Lakemountain-Keyboards/hardware/README.md

<div align="center">

  # Lakemountain Keyboards

  Hardware Repository

  Kicad Schematic & PCB layout

</div>
