Lakemountain-Keyboards/hardware/Left/Board2Pdf/left-Assembly.pdf

1 | 2 | 3 | 4 | 5 | 6

A

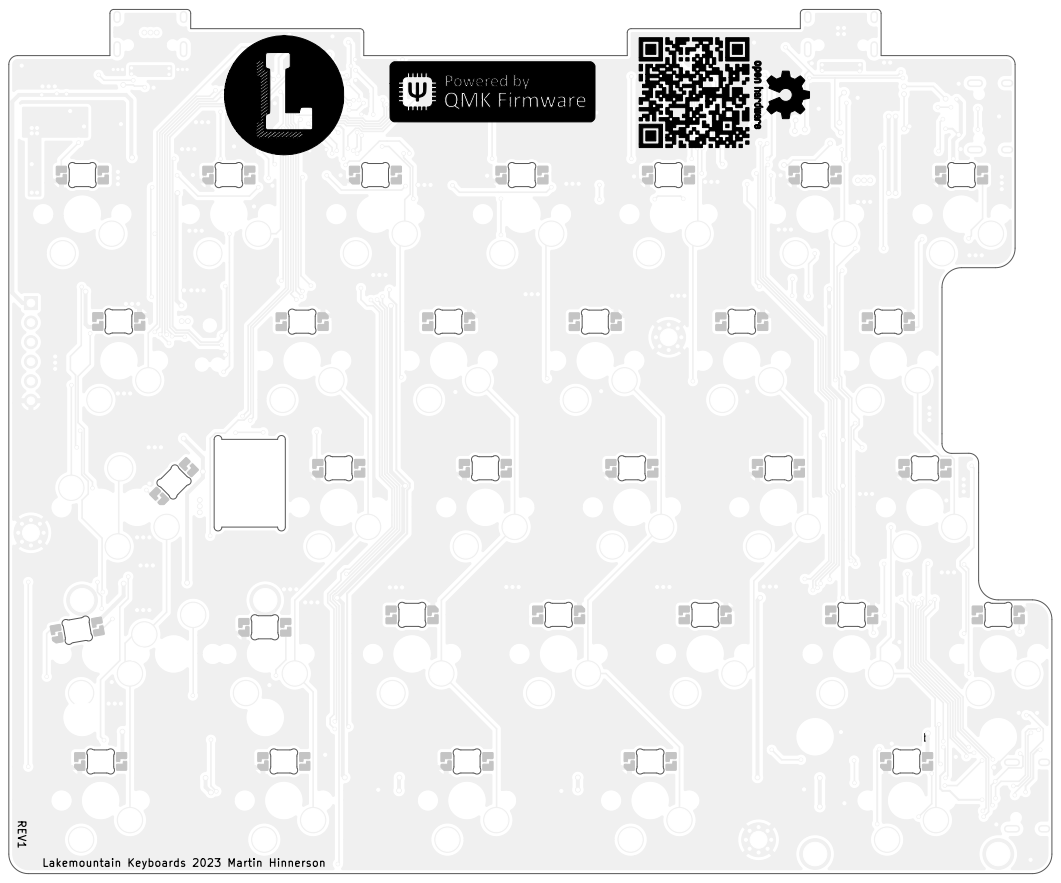
[picture p1: page 1]
D Date: 2023-03-12 KiCad; kicad; (6.0.11) Size: A4; Rev: 1; Id: 1/1 Title: Lakemountain Left File: left.kicad_pcb Sheet: BlackAndWhiteTop Lakemountain; Keyboards; MX_stab; MX_stab REV1; Lakemountain Keyboards 2023 Martin Hinnerson

1 | 2 | 3 | 4 | 5 | 6 1 | 2 | 3 | 4 | 5 | 6 ABCD | ABCD Date: 2023-03-12 KiCad | E.D.A. | kicad | (6.0.11) Size: A4 | Rev: 1
Lakemountain | Keyboards T15 | T13 ⁵.1k | R13 5.1k | R5 MUX_SEL SRV05-4 U11 SRV05-4 | U10

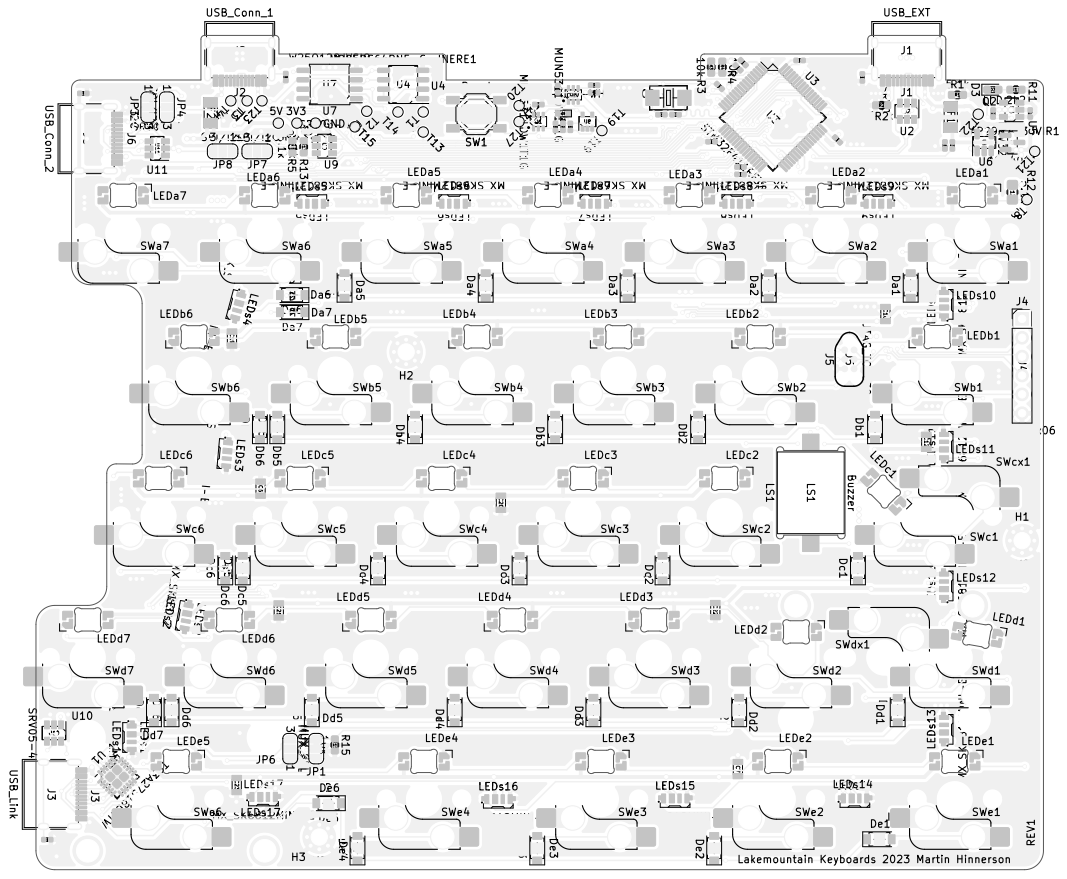
[picture p2: page 2]

Id: 1/1 Title: Lakemountain Left File: left.kicad_pcb Sheet: BlackAndWhiteBottom
