Lakemountain-Keyboards/hardware/Left/left.kicad_pcb

## KiCad design Left/left.kicad_pcb (2024-03-15)

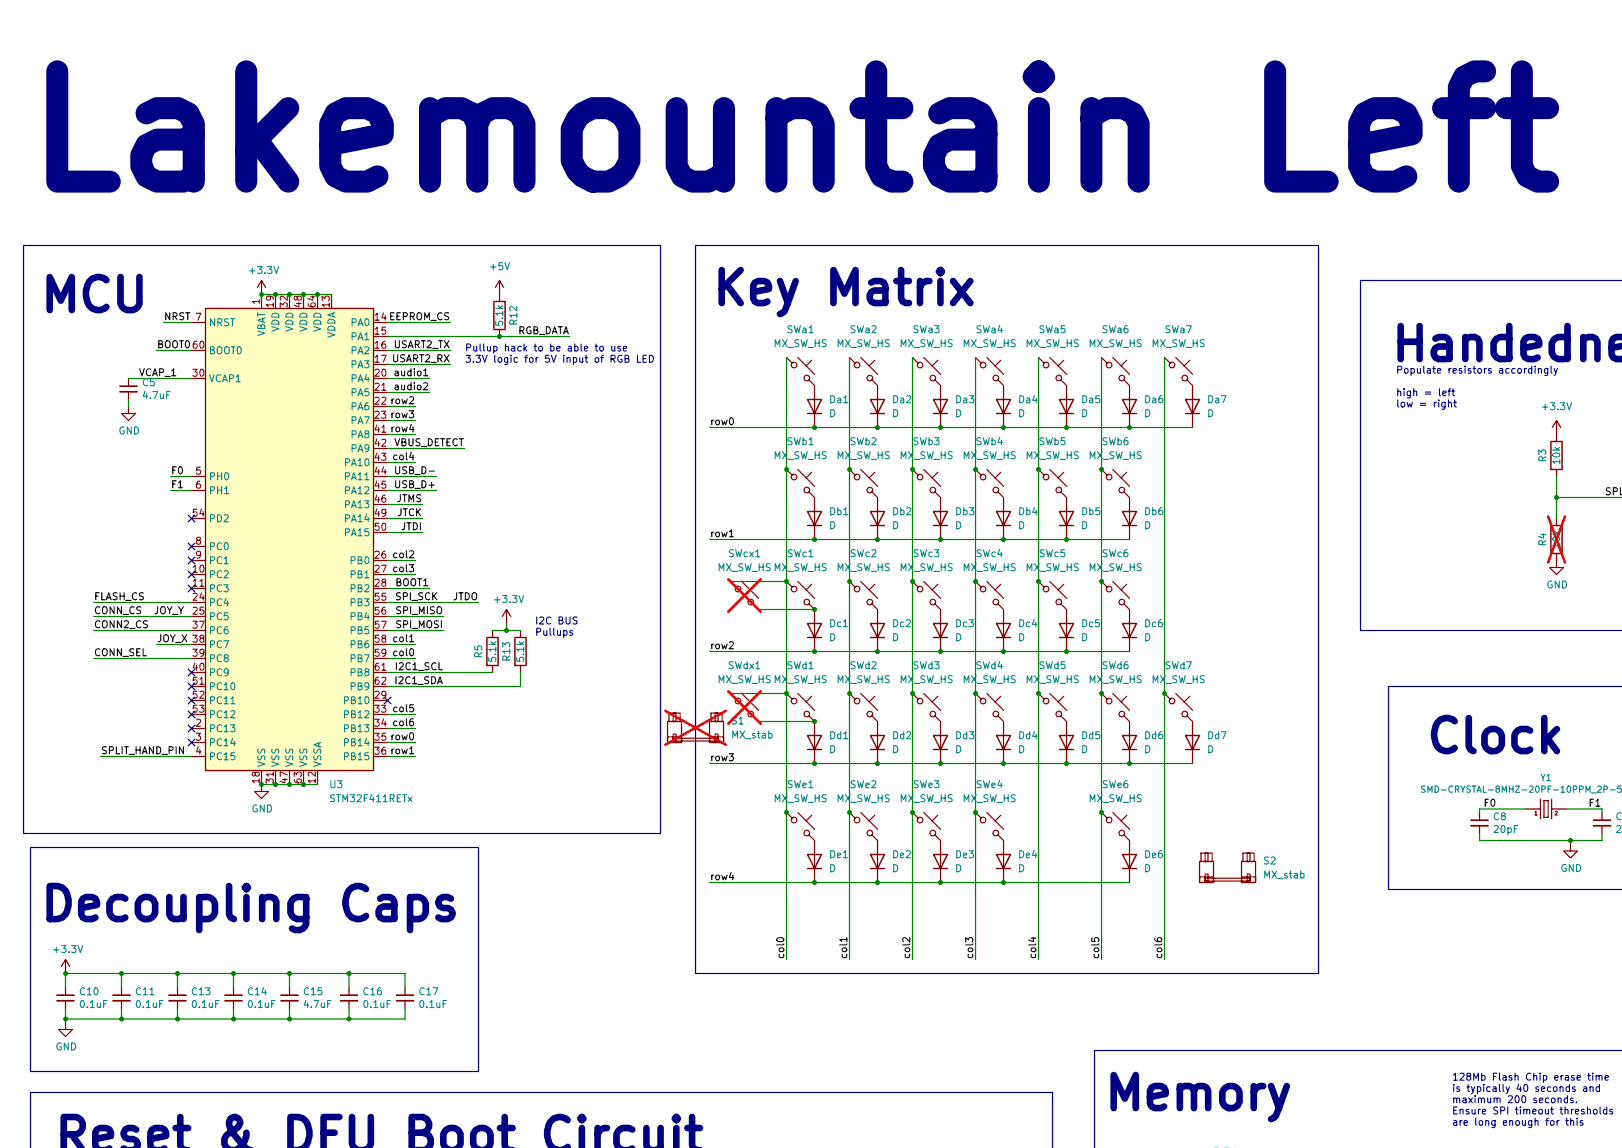
[picture p3: schematic left.kicad_sch, Lakemountain Left, part in row 1, column 1]

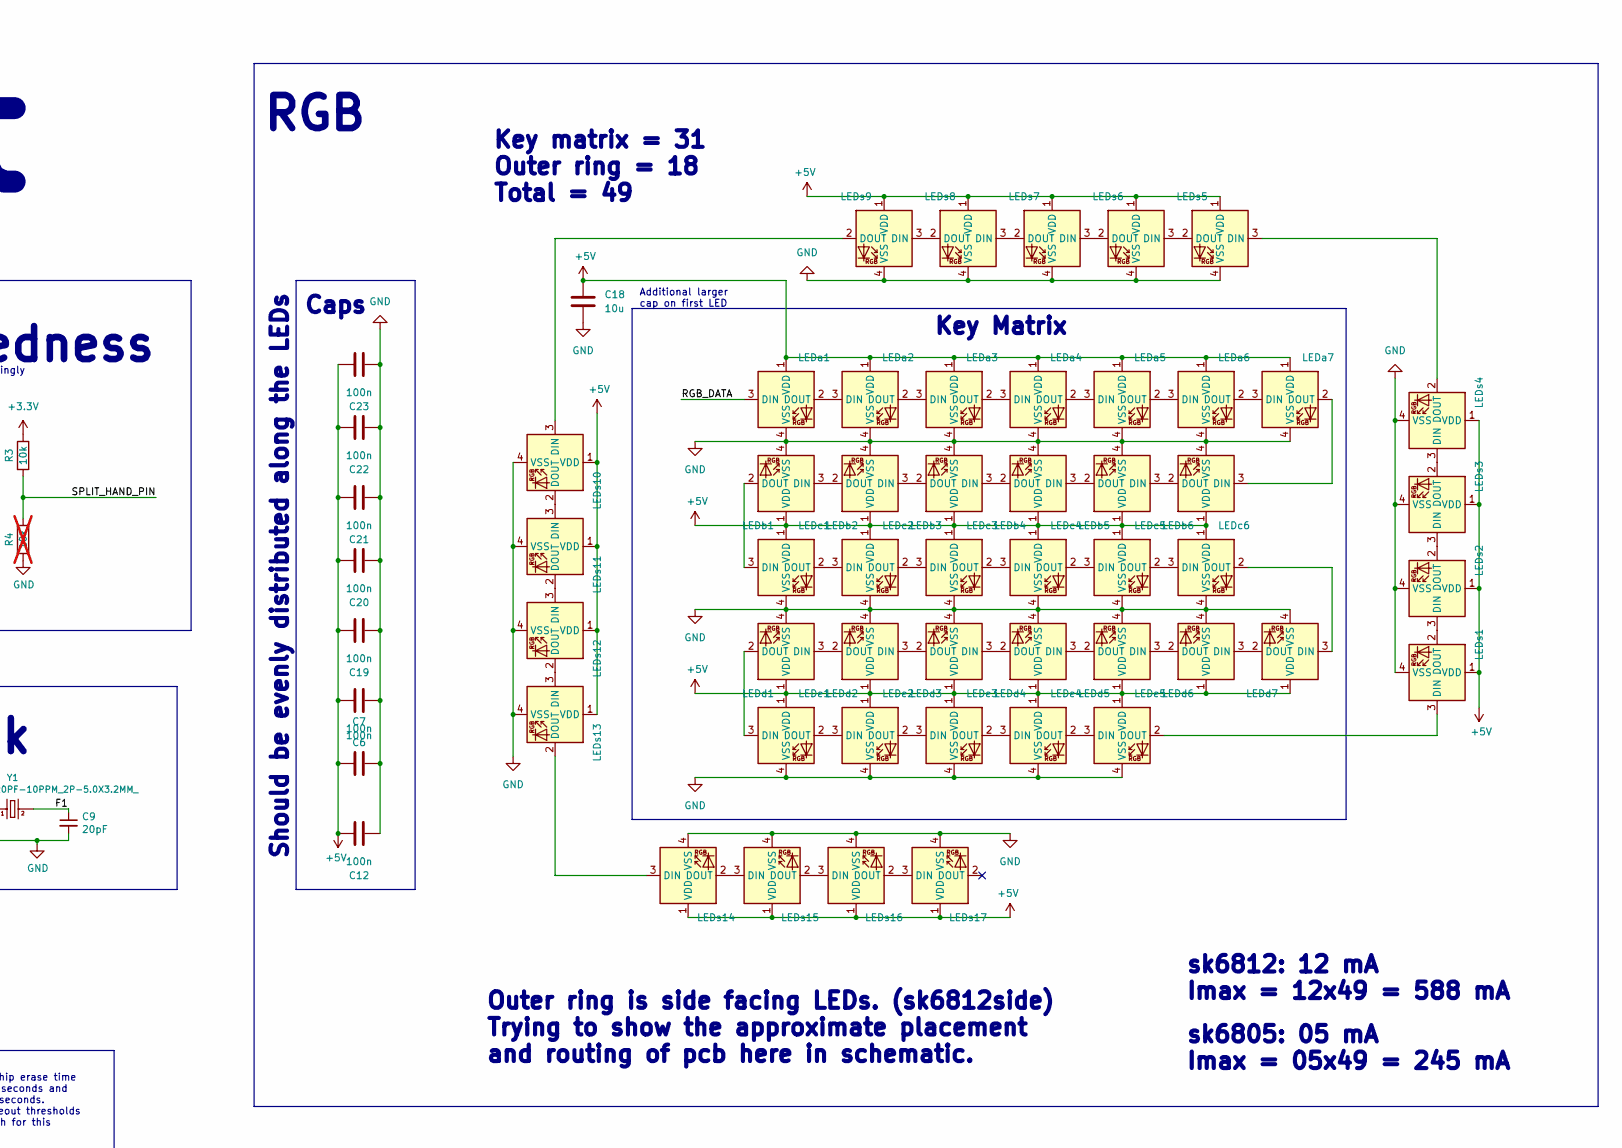
[picture p4: schematic left.kicad_sch, Lakemountain Left, part in row 1, column 2]

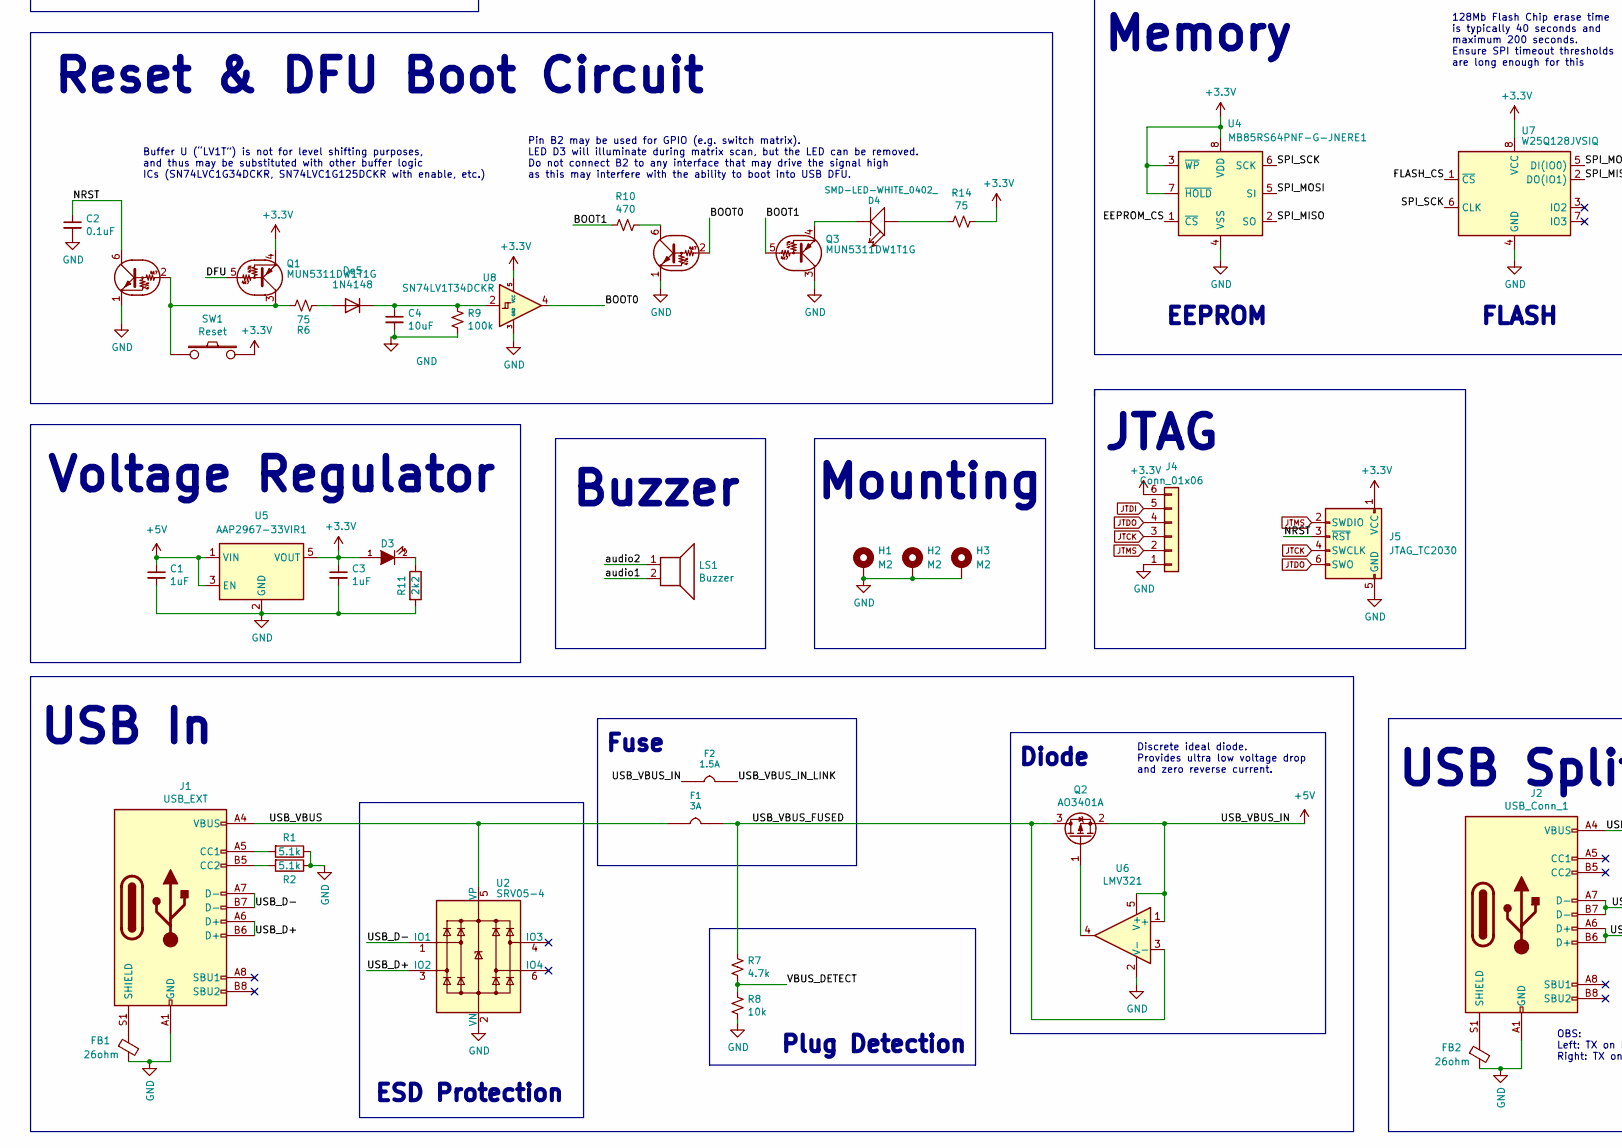
[picture p5: schematic left.kicad_sch, Lakemountain Left, part in row 2, column 1]

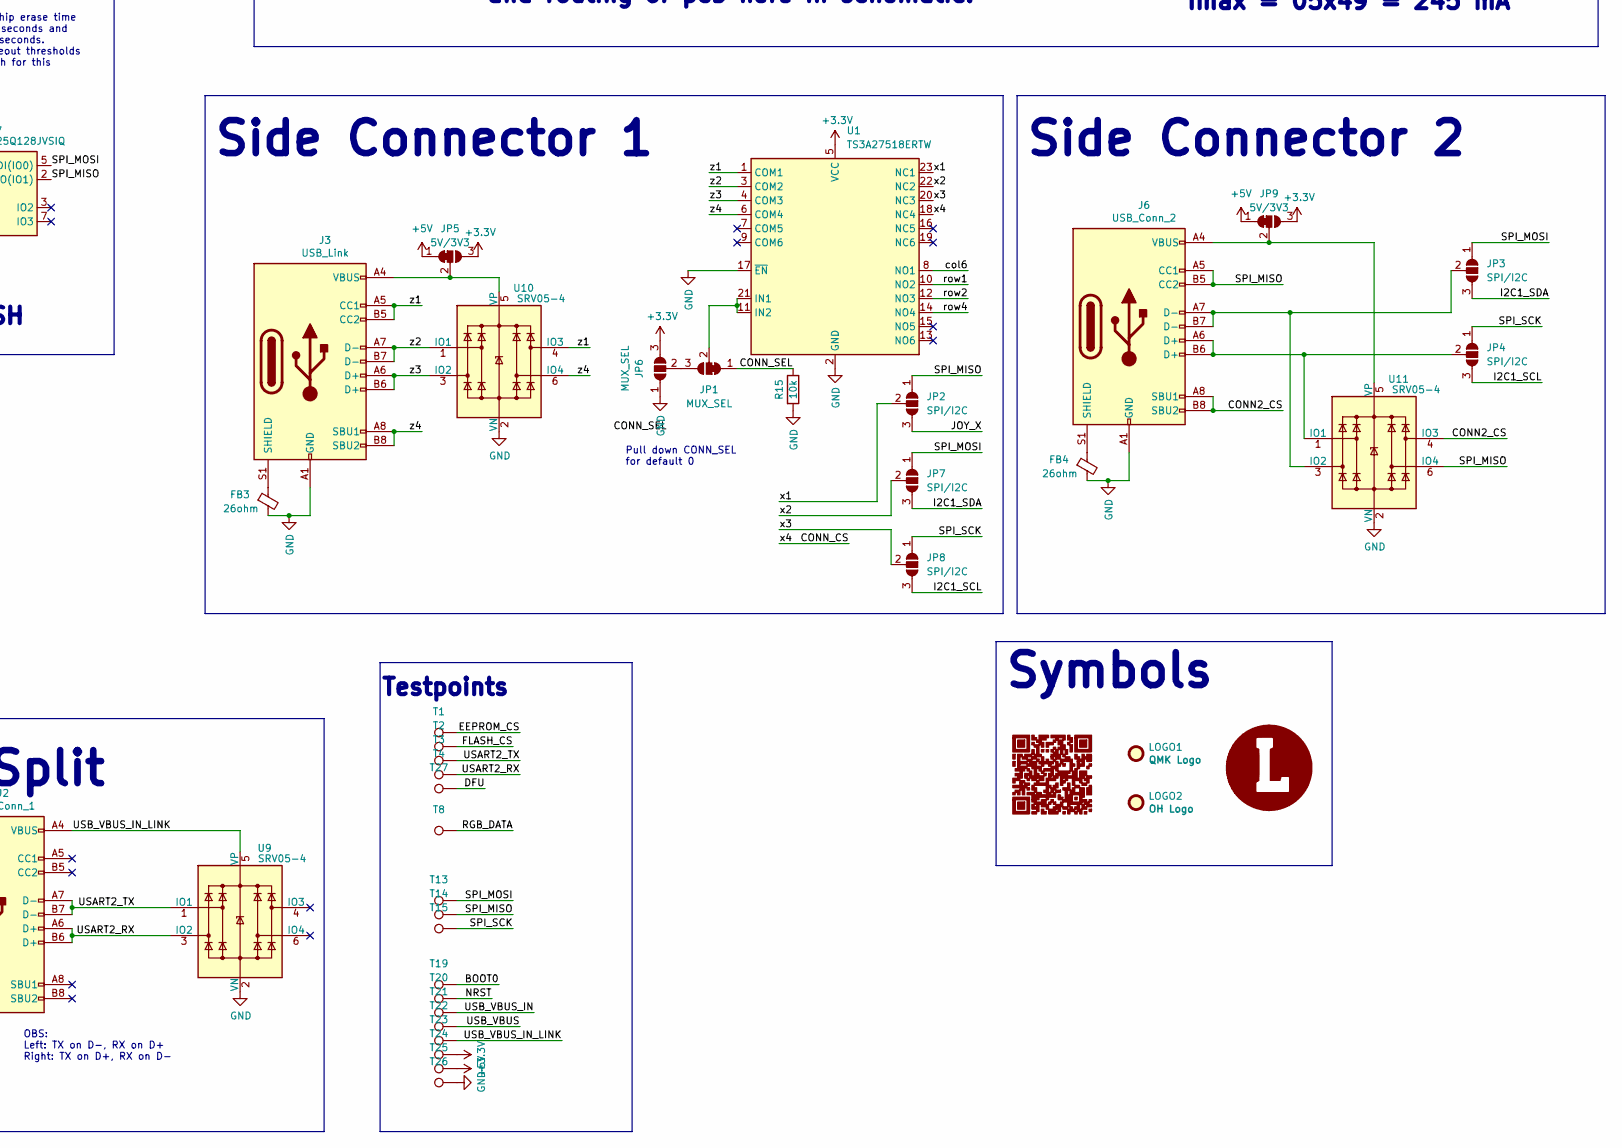
[picture p6: schematic left.kicad_sch, Lakemountain Left, part in row 2, column 2]

Parts:
C1, C3: cap_1uF_10v_0402; C_0402_1005Metric; MPN CC0402KRX5R6BB105; LCSC C52923
C2, C10, C11, C13, C14, C16, C17: cap_100nF_16v_0402; C_0402_1005Metric; MPN CL05B104KO5NNNC; LCSC C1525
C4: cap_10uF_10v_0402; C_0402_1005Metric; MPN CL10A106KP8NNNC; LCSC C19702
C5, C15: cap_4.7uF_10v_0402; C_0402_1005Metric; MPN CL05A475MP5NRNC; LCSC C23733
C6, C7, C12, C19, C20, C21, C22, C23: 100n; C_0805; LCSC C495959
C8, C9: cap_20pF_50v_0402; C_0402_1005Metric; MPN 0402CG200J500NT; LCSC C1554
C18: 10u; C_0805; LCSC C90544
D3: LED; LED_0603_1608Metric; LCSC Part C72041
D4: SMD-LED-WHITE_0402_; LED_0402; MPN 16-219A/T2D-AR2T1QY/3T; LCSC C74342
Da1, Da2, Da3, Da4, Da5, Da6, Da7: D; D_SOD-123; LCSC C81598
Db1, Db2, Db3, Db4, Db5, Db6: D; D_SOD-123; LCSC C81598
Dc1, Dc2, Dc3, Dc4, Dc5, Dc6: D; D_SOD-123; LCSC C81598
Dd1, Dd2, Dd3, Dd4, Dd5, Dd6, Dd7: D; D_SOD-123; LCSC C81598
De1, De2, De3, De4, De6: D; D_SOD-123; LCSC C81598
De5: 1N4148; D_SOD-523; LCSC C68948
F1: 3A; F1206; MPN SMD0805-050; LCSC C89656
F2: 1.5A; F1206; MPN SMD0805-050; LCSC C89655
FB1, FB2, FB3, FB4: fb_0402_26ohm; R_0402_1005Metric; MPN CBG100505U260T; LCSC C668229
H1, H2, H3: M2; MountingHole_2.2mm_M2_Pad_Via
J1: USB_EXT; USB_C_Receptacle_HRO_TYPE-C-31-M-12; Mouser C165948
J2: USB_Conn_1; USB_C_Receptacle_HRO_TYPE-C-31-M-12; Mouser C165948
J3: USB_Link; USB_C_Receptacle_HRO_TYPE-C-31-M-12; Mouser C165948
J4: Conn_01x06; PinHeader_1x06_P2.54mm_Vertical
J5: JTAG_TC2030; CON_TC2030_outlined
J6: USB_Conn_2; USB_C_Receptacle_HRO_TYPE-C-31-M-12; Mouser C165948
JP1: MUX_SEL; SolderJumper-3_P1.3mm_Bridged12_RoundedPad1.0x1.5mm
JP2, JP3, JP4, JP7, JP8: SPI/I2C; SolderJumper-3_P1.3mm_Open_RoundedPad1.0x1.5mm_NumberLabels
JP5, JP9: 5V/3V3; SolderJumper-3_P1.3mm_Bridged12_RoundedPad1.0x1.5mm
JP6: MUX_SEL; SolderJumper-3_P1.3mm_Open_RoundedPad1.0x1.5mm_NumberLabels
LEDa1, LEDa2, LEDa3, LEDa4, LEDa5, LEDa6, LEDa7: MX_SK6812MINI-E; LED_MX_6028R; LCSC C5149201
LEDb1, LEDb2, LEDb3, LEDb4, LEDb5, LEDb6: MX_SK6812MINI-E; LED_MX_6028R_Flipped; LCSC C5149201
LEDc1: MX_SK6812MINI-E; LED_MX_6028R_SOLO; LCSC C5149201
LEDc2, LEDc3, LEDc4, LEDc5, LEDc6: MX_SK6812MINI-E; LED_MX_6028R; LCSC C5149201
LEDd1, LEDd2: MX_SK6812MINI-E; LED_MX_6028R_SOLO; LCSC C5149201
LEDd3, LEDd4, LEDd5, LEDd6, LEDd7: MX_SK6812MINI-E; LED_MX_6028R_Flipped; LCSC C5149201
LEDe1, LEDe2, LEDe3, LEDe4, LEDe5: MX_SK6812MINI-E; LED_MX_6028R; LCSC C5149201
LEDs1, LEDs2, LEDs3, LEDs4, LEDs5, LEDs6, LEDs7, LEDs8, LEDs9, LEDs10, LEDs11, LEDs12, LEDs13, LEDs14, LEDs15, LEDs16, LEDs17: sk6812side; LCSC C2890037
LOGO1: QMK Logo; QMK_PoweredBy
LOGO2: OH Logo; OSHW-Logo2_9.8x8mm_SilkScreen
LS1: Buzzer; Buzzer_Mallory_AST1109MLTRQ; LCSC C201047
Q1, Q3: MUN5311DW1T1G; SOT-363_SC-70-6_SC-88; LCSC C152542
Q2: AO3401A; SOT-23; LCSC Part C15127
R1, R2, R5, R13: 5.1k; R_0603_1608Metric; Mouser C27834
R3, R15: 10k; R_0603_1608Metric; LCSC C25804
R4: 10k; R_0603_1608Metric; LCSC C25804; not fitted
R6, R14: r_75_0402_1p; R_0402_1005Metric; MPN 0402WGF750JTCE; LCSC C25133
R7: r_4.7k_0402_1p; R_0402_1005Metric; MPN 0402WGF4701TCE; LCSC C25900
R8: r_10k_0402_1p; R_0402_1005Metric; MPN 0402WGF1002TCE; LCSC C25744
R9: r_100k_0402_1p; R_0402_1005Metric; MPN 0402WGF1003TCE; LCSC C25741
R10: r_470_0402_1p; R_0402_1005Metric; MPN 0402WGF4700TCE; LCSC C25117
R11: 2k2; R_0603_1608Metric; LCSC C4190
R12: 5.1k; R_0805_2012Metric_Pad1.20x1.40mm_HandSolder; Mouser C27834
S1: MX_stab; STAB_MX_P_2.25u; JLCPCB BOM 0; not fitted
S2: MX_stab; STAB_MX_P_2.25u; JLCPCB BOM 0
SW1: Reset; SW_SPST_TL3342; Mouser C318884
SWa1, SWa2, SWa3, SWa4, SWa5, SWa6, SWa7: MX_SW_HS; SW_MX_HS_1u; LCSC C2803348
SWb1: MX_SW_HS; SW_MX_HS_1.5u; LCSC C2803348
SWb2, SWb3, SWb4, SWb5, SWb6: MX_SW_HS; SW_MX_HS_1u; LCSC C2803348
SWc1: MX_SW_HS; SW_MX_HS_1.75u; LCSC C2803348
SWc2, SWc3, SWc4, SWc5, SWc6: MX_SW_HS; SW_MX_HS_1u; LCSC C2803348
SWcx1: MX_SW_HS; SW_MX_HS_1.75u_stp; LCSC C2803348; not fitted
SWd1: MX_SW_HS; SW_MX_HS_1.25u; LCSC C2803348
SWd2, SWd3, SWd4, SWd5, SWd6, SWd7: MX_SW_HS; SW_MX_HS_1u; LCSC C2803348
SWdx1: MX_SW_HS; SW_MX_HS_2.25u; LCSC C2803348; not fitted
SWe1, SWe2, SWe3, SWe4: MX_SW_HS; SW_MX_HS_1.25u; LCSC C2803348
SWe6: MX_SW_HS; SW_MX_HS_2.25u; LCSC C2803348
T1, T2, T3, T4, T8, T13, T14, T15, T19, T20, T21, T22, T23: TP; TestPoint_Pad_D1.0mm
T24: 3V3; TestPoint_Pad_D1.0mm
T25: 5V; TestPoint_Pad_D1.0mm
T26, T27: GND; TestPoint_Pad_D1.0mm
U1: TS3A27518ERTW; WQFN-24-1EP_4x4mm_P0.5mm_EP2.6x2.6mm; LCSC C2651937
U2, U9, U10, U11: SRV05-4; SOT-23-6; LCSC C85364
U3: STM32F411RETx; LQFP-64_10x10mm_P0.5mm
U4: MB85RS64PNF-G-JNERE1; SOP-8_3.9x4.9mm_P1.27mm; LCSC C8741
U5: AAP2967-33VIR1; SOT-23-5; LCSC C370742
U6: LMV321; SOT-23-5; JLCPCB BOM 1
U7: W25Q128JVSIQ; SOIC-8_5.23x5.23mm_P1.27mm; LCSC C97521
U8: SN74LV1T34DCKR; SOT-353_SC-70-5; LCSC C78541
Y1: SMD-CRYSTAL-8MHZ-20PF-10PPM_2P-5.0X3.2MM_; X2-SMD-5.0X3.2X1.3MM; MPN X50328MSB2GI; LCSC C115962

Connections:
+3.3V: C3.1, C10.1, C11.1, C13.1, C14.1, C15.1, C16.1, C17.1, D3.1 (A), J4.6, J5.1 (VCC), JP5.3 (B), JP6.3 (B), JP9.3 (B), Q1.4 (E), R3.1, R5.1, R13.1, R14.1, SW1.2, T24.1, U1.5 (VCC), U3.1 (VBAT), U3.13 (VDDA), U3.19 (VDD), U3.32 (VDD), U3.48 (VDD), U3.64 (VDD), U4.3 (~WP), U4.7 (~HOLD), U4.8 (VDD), U5.5 (VOUT), U7.8 (VCC), U8.5 (VCC)
+5V: C1.1, C6.1, C7.1, C12.1, C18.1, C19.1, C20.2, C21.1, C22.2, C23.1, F2.2, JP5.1 (A), JP9.1 (A), LEDa1.1 (VDD), LEDa2.1 (VDD), LEDa3.1 (VDD), LEDa4.1 (VDD), LEDa5.1 (VDD), LEDa6.1 (VDD), LEDa7.1 (VDD), LEDb1.1 (VDD), LEDb2.1 (VDD), LEDb3.1 (VDD), LEDb4.1 (VDD), LEDb5.1 (VDD), LEDb6.1 (VDD), LEDc1.1 (VDD), LEDc2.1 (VDD), LEDc3.1 (VDD), LEDc4.1 (VDD), LEDc5.1 (VDD), LEDc6.1 (VDD), LEDd1.1 (VDD), LEDd2.1 (VDD), LEDd3.1 (VDD), LEDd4.1 (VDD), LEDd5.1 (VDD), LEDd6.1 (VDD), LEDd7.1 (VDD), LEDe1.1 (VDD), LEDe2.1 (VDD), LEDe3.1 (VDD), LEDe4.1 (VDD), LEDe5.1 (VDD), LEDs1.1 (VDD), LEDs2.1 (VDD), LEDs3.1 (VDD), LEDs4.1 (VDD), LEDs5.1 (VDD), LEDs6.1 (VDD), LEDs7.1 (VDD), LEDs8.1 (VDD), LEDs9.1 (VDD), LEDs10.1 (VDD), LEDs11.1 (VDD), LEDs12.1 (VDD), LEDs13.1 (VDD), LEDs14.1 (VDD), LEDs15.1 (VDD), LEDs16.1 (VDD), LEDs17.1 (VDD), Q2.2 (S), R12.2, T21.1, T25.1, U5.1 (VIN), U5.3 (EN), U6.1 (+), U6.5 (V+)
/BOOT0: Q3.2 (B), T19.1, U3.60 (BOOT0), U8.4
/BOOT1: Q3.5, R10.2, U3.28 (PB2)
/CONN2_CS: J6.A8 (SBU1), J6.B8 (SBU2), U3.37 (PC6), U11.4 (IO3)
/CONN_CS: U1.18 (NC4), U3.25 (PC5)
/CONN_SEL: JP1.1 (A), R15.1, U3.39 (PC8)
/DFU: Q1.5, T27.1
/EEPROM_CS: T1.1, U3.14 (PA0), U4.1 (~CS)
/F0: C8.1, U3.5 (PH0), Y1.1
/F1: C9.1, U3.6 (PH1), Y1.2
/FLASH_CS: T2.1, U3.24 (PC4), U7.1 (~CS)
/I2C1_SCL: JP4.3 (B), JP8.3 (B), R5.2, U3.61 (PB8)
/I2C1_SDA: JP3.3 (B), JP7.3 (B), R13.2, U3.62 (PB9)
/JOY_X: JP2.3 (B), U3.38 (PC7)
/NRST: C2.1, J5.3 (~RST), Q1.6 (C), T20.1, U3.7 (NRST)
/RGB_DATA: LEDa1.3 (DIN), R12.1, T8.1, U3.15 (PA1)
/SPI_MISO: J6.A5 (CC1), J6.B5 (CC2), JP2.1 (A), T14.1, U3.56 (PB4), U4.2 (SO), U7.2 (DO(IO1)), U11.6 (IO4)
/SPI_MOSI: JP3.1 (A), JP7.1 (A), T13.1, U3.57 (PB5), U4.5 (SI), U7.5 (DI(IO0))
/SPLIT_HAND_PIN: R3.2, R4.1, U3.4 (PC15)
/USART2_RX: J2.A6 (D+), J2.B6 (D+), T4.1, U3.17 (PA3), U9.3 (IO2)
/USART2_TX: J2.A7 (D-), J2.B7 (D-), T3.1, U3.16 (PA2), U9.1 (IO1)
/USB_D+: J1.A6 (D+), J1.B6 (D+), U2.3 (IO2), U3.45 (PA12)
/USB_D-: J1.A7 (D-), J1.B7 (D-), U2.1 (IO1), U3.44 (PA11)
/USB_VBUS: F1.2, J1.A4 (VBUS), J1.A9 (VBUS), J1.B4 (VBUS), J1.B9 (VBUS), T22.1, U2.5 (VP)
/USB_VBUS_FUSED: F1.1, Q2.3 (D), R7.1, U6.3 (-)
/USB_VBUS_IN_LINK: F2.1, J2.A4 (VBUS), J2.A9 (VBUS), J2.B4 (VBUS), J2.B9 (VBUS), T23.1, U9.5 (VP)
/VBUS_DETECT: R7.2, R8.1, U3.42 (PA9)
/VCAP_1: C5.1, U3.30 (VCAP1)
/audio1: LS1.2, U3.20 (PA4)
/audio2: LS1.1, U3.21 (PA5)
/col0: SWa1.1, SWb1.1, SWc1.1, SWcx1.1, SWd1.1, SWdx1.1, SWe1.1, U3.59 (PB7)
/col1: SWa2.1, SWb2.1, SWc2.1, SWd2.1, SWe2.1, U3.58 (PB6)
/col2: SWa3.1, SWb3.1, SWc3.1, SWd3.1, SWe3.1, U3.26 (PB0)
/col3: SWa4.1, SWb4.1, SWc4.1, SWd4.1, SWe4.1, U3.27 (PB1)
/col4: SWa5.1, SWb5.1, SWc5.1, SWd5.1, U3.43 (PA10)
/col5: SWa6.1, SWb6.1, SWc6.1, SWd6.1, SWe6.1, U3.33 (PB12)
/col6: SWa7.1, SWd7.1, U1.8 (NO1), U3.34 (PB13)
/row0: Da1.1 (K), Da2.1 (K), Da3.1 (K), Da4.1 (K), Da5.1 (K), Da6.1 (K), Da7.1 (K), U3.35 (PB14)
/row1: Db1.1 (K), Db2.1 (K), Db3.1 (K), Db4.1 (K), Db5.1 (K), Db6.1 (K), U1.10 (NO2), U3.36 (PB15)
/row2: Dc1.1 (K), Dc2.1 (K), Dc3.1 (K), Dc4.1 (K), Dc5.1 (K), Dc6.1 (K), U1.12 (NO3), U3.22 (PA6)
/row3: Dd1.1 (K), Dd2.1 (K), Dd3.1 (K), Dd4.1 (K), Dd5.1 (K), Dd6.1 (K), Dd7.1 (K), U3.23 (PA7)
/row4: De1.1 (K), De2.1 (K), De3.1 (K), De4.1 (K), De6.1 (K), U1.14 (NO4), U3.41 (PA8)
/x1: JP2.2 (C), U1.23 (NC1)
/x2: JP7.2 (C), U1.22 (NC2)
/x3: JP8.2 (C), U1.20 (NC3)
/z1: J3.A5 (CC1), J3.B5 (CC2), U1.1 (COM1), U10.4 (IO3)
/z2: J3.A7 (D-), J3.B7 (D-), U1.3 (COM2), U10.1 (IO1)
/z3: J3.A6 (D+), J3.B6 (D+), U1.4 (COM3), U10.3 (IO2)
/z4: J3.A8 (SBU1), J3.B8 (SBU2), U1.6 (COM4), U10.6 (IO4)
GND: C1.2, C2.2, C3.2, C4.2, C5.2, C6.2, C7.2, C8.2, C9.2, C10.2, C11.2, C12.2, C13.2, C14.2, C15.2, C16.2, C17.2, C18.2, C19.2, C20.1, C21.2, C22.1, C23.2, FB1.2, FB2.2, FB3.2, FB4.2, H1.1, H2.1, H3.1, J1.A1 (GND), J1.A12 (GND), J1.B1 (GND), J1.B12 (GND), J2.A1 (GND), J2.A12 (GND), J2.B1 (GND), J2.B12 (GND), J3.A1 (GND), J3.A12 (GND), J3.B1 (GND), J3.B12 (GND), J4.1, J5.5 (GND), J6.A1 (GND), J6.A12 (GND), J6.B1 (GND), J6.B12 (GND), JP6.1 (A), LEDa1.4 (VSS), LEDa2.4 (VSS), LEDa3.4 (VSS), LEDa4.4 (VSS), LEDa5.4 (VSS), LEDa6.4 (VSS), LEDa7.4 (VSS), LEDb1.4 (VSS), LEDb2.4 (VSS), LEDb3.4 (VSS), LEDb4.4 (VSS), LEDb5.4 (VSS), LEDb6.4 (VSS), LEDc1.4 (VSS), LEDc2.4 (VSS), LEDc3.4 (VSS), LEDc4.4 (VSS), LEDc5.4 (VSS), LEDc6.4 (VSS), LEDd1.4 (VSS), LEDd2.4 (VSS), LEDd3.4 (VSS), LEDd4.4 (VSS), LEDd5.4 (VSS), LEDd6.4 (VSS), LEDd7.4 (VSS), LEDe1.4 (VSS), LEDe2.4 (VSS), LEDe3.4 (VSS), LEDe4.4 (VSS), LEDe5.4 (VSS), LEDs1.4 (VSS), LEDs2.4 (VSS), LEDs3.4 (VSS), LEDs4.4 (VSS), LEDs5.4 (VSS), LEDs6.4 (VSS), LEDs7.4 (VSS), LEDs8.4 (VSS), LEDs9.4 (VSS), LEDs10.4 (VSS), LEDs11.4 (VSS), LEDs12.4 (VSS), LEDs13.4 (VSS), LEDs14.4 (VSS), LEDs15.4 (VSS), LEDs16.4 (VSS), LEDs17.4 (VSS), Q1.1 (E), Q3.1 (E), Q3.3 (C), R1.1, R2.1, R4.2, R8.2, R9.2, R11.2, R15.2, T26.1, U1.2 (GND), U1.17 (~EN), U1.25 (GND), U2.2 (VN), U3.12 (VSSA), U3.18 (VSS), U3.31 (VSS), U3.47 (VSS), U3.63 (VSS), U4.4 (VSS), U5.2 (GND), U6.2 (V-), U7.4 (GND), U8.3 (GND), U9.2 (VN), U10.2 (VN), U11.2 (VN)
JTCK: J4.3, J5.4 (SWCLK), U3.49 (PA14)
JTDI: J4.5, U3.50 (PA15)
JTDO: J4.4, J5.6 (SWO), JP4.1 (A), JP8.1 (A), T15.1, U3.55 (PB3), U4.6 (SCK), U7.6 (CLK)
JTMS: J4.2, J5.2 (SWDIO), U3.46 (PA13)
unnamed: D3.2 (K), R11.1
unnamed: D4.+, R14.2
unnamed: D4.-, Q3.4 (E)
unnamed: Da1.2 (A), SWa1.2
unnamed: Da2.2 (A), SWa2.2
unnamed: Da3.2 (A), SWa3.2
unnamed: Da4.2 (A), SWa4.2
unnamed: Da5.2 (A), SWa5.2
unnamed: Da6.2 (A), SWa6.2
unnamed: Da7.2 (A), SWa7.2
unnamed: Db1.2 (A), SWb1.2
unnamed: Db2.2 (A), SWb2.2
unnamed: Db3.2 (A), SWb3.2
unnamed: Db4.2 (A), SWb4.2
unnamed: Db5.2 (A), SWb5.2
unnamed: Db6.2 (A), SWb6.2
unnamed: Dc1.2 (A), SWc1.2, SWcx1.2
unnamed: Dc2.2 (A), SWc2.2
unnamed: Dc3.2 (A), SWc3.2
unnamed: Dc4.2 (A), SWc4.2
unnamed: Dc5.2 (A), SWc5.2
unnamed: Dc6.2 (A), SWc6.2
unnamed: Dd1.2 (A), SWd1.2, SWdx1.2
unnamed: Dd2.2 (A), SWd2.2
unnamed: Dd3.2 (A), SWd3.2
unnamed: Dd4.2 (A), SWd4.2
unnamed: Dd5.2 (A), SWd5.2
unnamed: Dd6.2 (A), SWd6.2
unnamed: Dd7.2 (A), SWd7.2
unnamed: De1.2 (A), SWe1.2
unnamed: De2.2 (A), SWe2.2
unnamed: De3.2 (A), SWe3.2
unnamed: De4.2 (A), SWe4.2
unnamed: De5.2 (A), R6.2
unnamed: C4.1, De5.1 (K), R9.1, U8.2
unnamed: De6.2 (A), SWe6.2
unnamed: J1.A5 (CC1), R1.2
unnamed: J1.B5 (CC2), R2.2
unnamed: FB1.1, J1.S1 (SHIELD)
unnamed: FB2.1, J2.S1 (SHIELD)
unnamed: FB3.1, J3.S1 (SHIELD)
unnamed: FB4.1, J6.S1 (SHIELD)
unnamed: JP1.3 (B), JP6.2 (C)
unnamed: JP1.2 (C), U1.11 (IN2), U1.21 (IN1)
unnamed: J6.A7 (D-), J6.B7 (D-), JP3.2 (C), U11.3 (IO2)
unnamed: J6.A6 (D+), J6.B6 (D+), JP4.2 (C), U11.1 (IO1)
unnamed: J3.A4 (VBUS), J3.A9 (VBUS), J3.B4 (VBUS), J3.B9 (VBUS), JP5.2 (C), U10.5 (VP)
unnamed: J6.A4 (VBUS), J6.A9 (VBUS), J6.B4 (VBUS), J6.B9 (VBUS), JP9.2 (C), U11.5 (VP)
unnamed: LEDa1.2 (DOUT), LEDa2.3 (DIN)
unnamed: LEDa2.2 (DOUT), LEDa3.3 (DIN)
unnamed: LEDa3.2 (DOUT), LEDa4.3 (DIN)
unnamed: LEDa4.2 (DOUT), LEDa5.3 (DIN)
unnamed: LEDa5.2 (DOUT), LEDa6.3 (DIN)
unnamed: LEDa6.2 (DOUT), LEDa7.3 (DIN)
unnamed: LEDa7.2 (DOUT), LEDb6.3 (DIN)
unnamed: LEDb1.3 (DIN), LEDb2.2 (DOUT)
unnamed: LEDb1.2 (DOUT), LEDc1.3 (DIN)
unnamed: LEDb2.3 (DIN), LEDb3.2 (DOUT)
unnamed: LEDb3.3 (DIN), LEDb4.2 (DOUT)
unnamed: LEDb4.3 (DIN), LEDb5.2 (DOUT)
unnamed: LEDb5.3 (DIN), LEDb6.2 (DOUT)
unnamed: LEDc1.2 (DOUT), LEDc2.3 (DIN)
unnamed: LEDc2.2 (DOUT), LEDc3.3 (DIN)
unnamed: LEDc3.2 (DOUT), LEDc4.3 (DIN)
unnamed: LEDc4.2 (DOUT), LEDc5.3 (DIN)
unnamed: LEDc5.2 (DOUT), LEDc6.3 (DIN)
unnamed: LEDc6.2 (DOUT), LEDd7.3 (DIN)
unnamed: LEDd1.3 (DIN), LEDd2.2 (DOUT)
unnamed: LEDd1.2 (DOUT), LEDe1.3 (DIN)
unnamed: LEDd2.3 (DIN), LEDd3.2 (DOUT)
unnamed: LEDd3.3 (DIN), LEDd4.2 (DOUT)
unnamed: LEDd4.3 (DIN), LEDd5.2 (DOUT)
unnamed: LEDd5.3 (DIN), LEDd6.2 (DOUT)
unnamed: LEDd6.3 (DIN), LEDd7.2 (DOUT)
unnamed: LEDe1.2 (DOUT), LEDe2.3 (DIN)
unnamed: LEDe2.2 (DOUT), LEDe3.3 (DIN)
unnamed: LEDe3.2 (DOUT), LEDe4.3 (DIN)
unnamed: LEDe4.2 (DOUT), LEDe5.3 (DIN)
unnamed: LEDe5.2 (DOUT), LEDs1.3 (DIN)
unnamed: LEDs1.2 (DOUT), LEDs2.3 (DIN)
unnamed: LEDs2.2 (DOUT), LEDs3.3 (DIN)
unnamed: LEDs3.2 (DOUT), LEDs4.3 (DIN)
unnamed: LEDs4.2 (DOUT), LEDs5.3 (DIN)
unnamed: LEDs5.2 (DOUT), LEDs6.3 (DIN)
unnamed: LEDs6.2 (DOUT), LEDs7.3 (DIN)
unnamed: LEDs7.2 (DOUT), LEDs8.3 (DIN)
unnamed: LEDs8.2 (DOUT), LEDs9.3 (DIN)
unnamed: LEDs9.2 (DOUT), LEDs10.3 (DIN)
unnamed: LEDs10.2 (DOUT), LEDs11.3 (DIN)
unnamed: LEDs11.2 (DOUT), LEDs12.3 (DIN)
unnamed: LEDs12.2 (DOUT), LEDs13.3 (DIN)
unnamed: LEDs13.2 (DOUT), LEDs14.3 (DIN)
unnamed: LEDs14.2 (DOUT), LEDs15.3 (DIN)
unnamed: LEDs15.2 (DOUT), LEDs16.3 (DIN)
unnamed: LEDs16.2 (DOUT), LEDs17.3 (DIN)
unnamed: Q1.2 (B), Q1.3 (C), R6.1, SW1.1
unnamed: Q2.1 (G), U6.4
unnamed: Q3.6 (C), R10.1

Notes on the sheet:
128Mb Flash Chip erase time is typically 40 seconds and maximum 200 seconds. Ensure SPI timeout thresholds are long enough for this
Side Connector 1
USB In
Plug Detection
Caps
Memory
Decoupling Caps
I2C BUS Pullups
Handedness
Pull down CONN_SEL for default 0
Pin B2 may be used for GPIO (e.g. switch matrix). LED D3 will illuminate during matrix scan, but the LED can be removed. Do not connect B2 to any interface that may drive the signal high as this may interfere with the ability to boot into USB DFU.
USB Split
ESD Protection
Voltage Regulator
Diode
sk6812: 12 mA Imax = 12x49 = 588 mA
Additional larger cap on first LED
Should be evenly distributed along the LEDs
Clock
EEPROM
Symbols
Discrete ideal diode. Provides ultra low voltage drop and zero reverse current.
Populate resistors accordingly high = left low = right
OBS: Left: TX on D-, RX on D+ Right: TX on D+, RX on D-
MCU
sk6805: 05 mA Imax = 05x49 = 245 mA
Buffer U (“LV1T”) is not for level shifting purposes, and thus may be substituted with other buffer logic ICs (SN74LVC1G34DCKR, SN74LVC1G125DCKR with enable, etc.)
Key Matrix
JTAG
Fuse
Testpoints
Side Connector 2
Outer ring is side facing LEDs. (sk6812side) Trying to show the approximate placement and routing of pcb here in schematic.
Pullup hack to be able to use 3.3V logic for 5V input of RGB LED
Key matrix = 31 Outer ring = 18 Total = 49
FLASH
Mounting
Buzzer
Reset & DFU Boot Circuit
Lakemountain Left
RGB

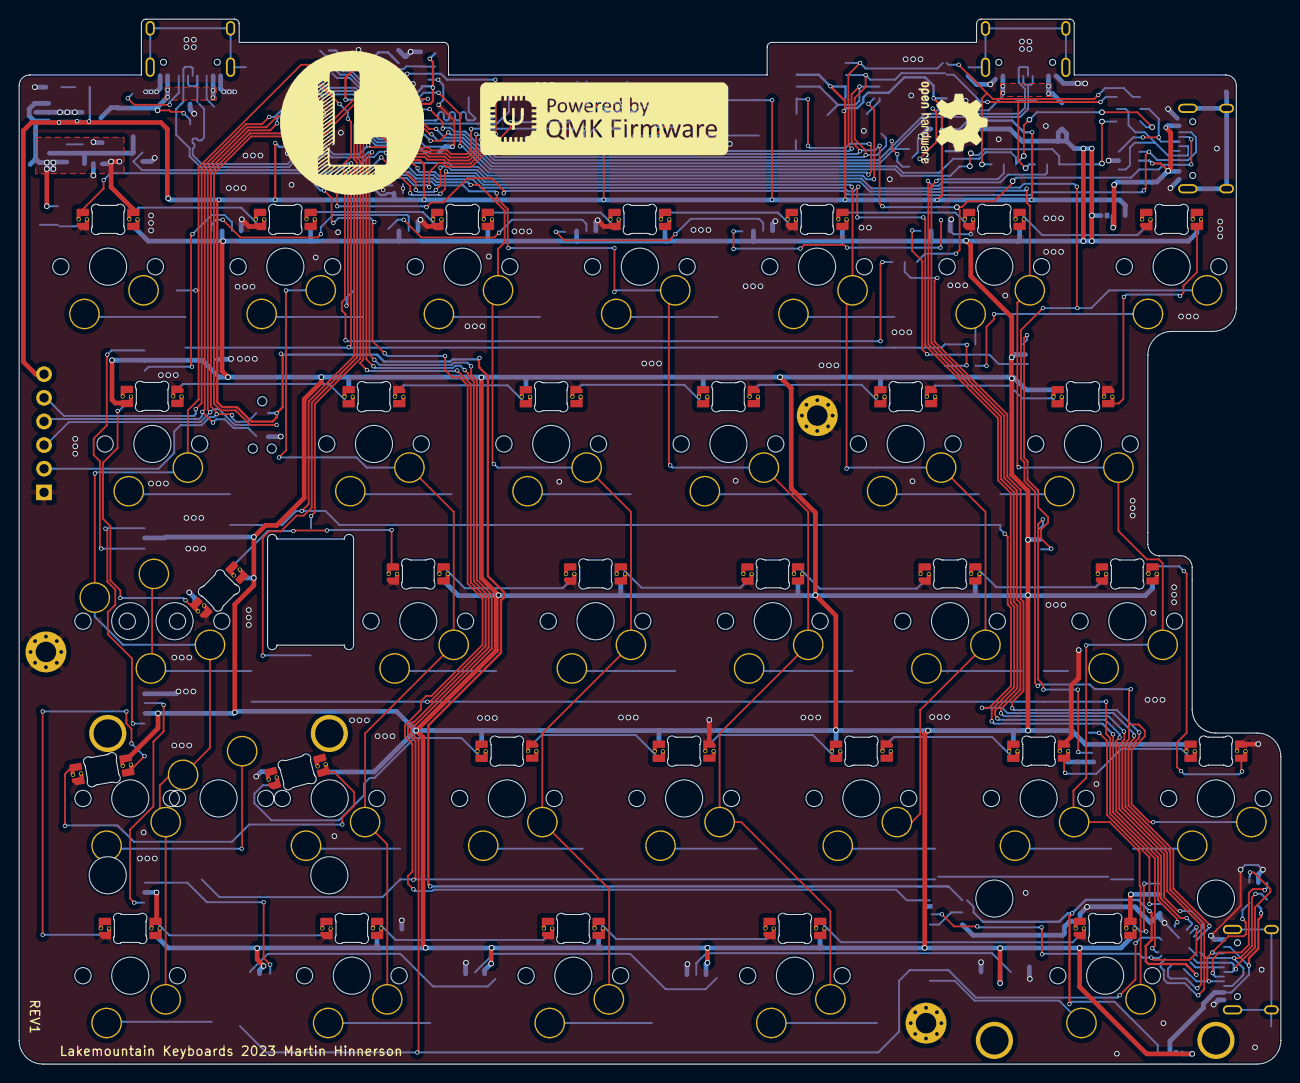
[picture p7: board left.kicad_pcb from above]

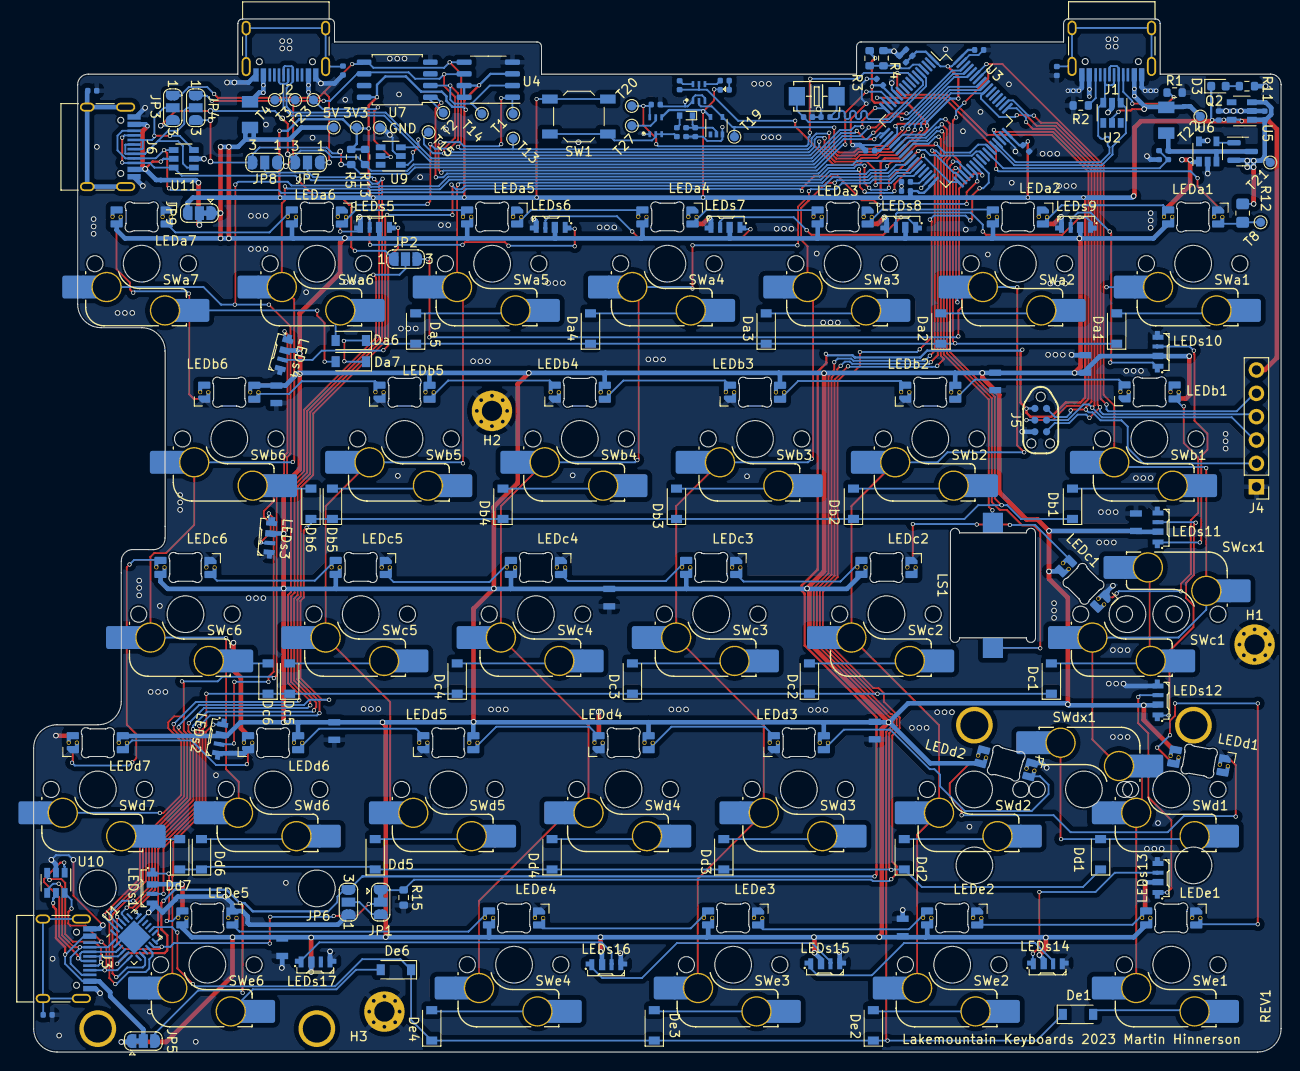
[picture p8: board left.kicad_pcb from below]

Board: 2 copper layers, 135.6 x 112.3 mm, 215 parts (211 on the bottom side), 153 nets.
