Lakemountain-Keyboards/hardware/(commit log)

2023-02-14 Add left PCB
    [bom.csv, designators.csv, lakemountain.csv, lakemountain.kicad_sch, positions.csv]
2023-03-07 Add right half. Not done with layout yet
    [CON_BM02B-ACHSS.step, CON_MJ-4PP-9.step, CON_SM02B-SRSS-TB.step, CON_SM04B-SRSS-TB.step, CON_SM05B-SRSS-TB.step, CON_SM06B-SRSS-TB.step, CON_SM07B-SRSS-TB.step, CON_SM08B-SRSS-TB.step]
2023-03-07 Before rotating switches and LEDs...
    [left.kicad_sch, right.kicad_sch]
2023-03-11 Started rotating all switches; More progress on right half
    [bom.csv, designators.csv, left.kicad_sch, left_JLCPCB_BoM.csv, positions.csv, right.kicad_sch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]
2023-03-12 Left PCB done, for now at least
    [left.csv, left.kicad_sch, left_JLCPCB_BoM.csv, right.kicad_sch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]
2023-03-12 Add all symbols and footprints to library
    [bom.csv, designators.csv, left.kicad_sch, positions.csv]
2023-03-12 Remove unused libs
    [CON_BM02B-ACHSS.step, CON_MJ-4PP-9.step, CON_SM02B-SRSS-TB.step, CON_SM04B-SRSS-TB.step, CON_SM05B-SRSS-TB.step, CON_SM06B-SRSS-TB.step, CON_SM07B-SRSS-TB.step, CON_SM08B-SRSS-TB.step]
2023-03-28 Right PCB routed. Needs DRC and some symbol fixing.
    [cirque_module.kicad_pcb, cirque_module.kicad_sch, left.kicad_pcb, left.kicad_sch, right.kicad_sch]
2023-04-01 Update right schematic symbols
    [right.kicad_sch]
2023-04-01 Export right footprints to libs
2024-03-15 Push latest, don't remember changes...
    [left.kicad_pcb, right.kicad_sch]
